ZigZagJoe/Acorn-A3010-Overclock-Board/Acorn Vent switch clip.stl

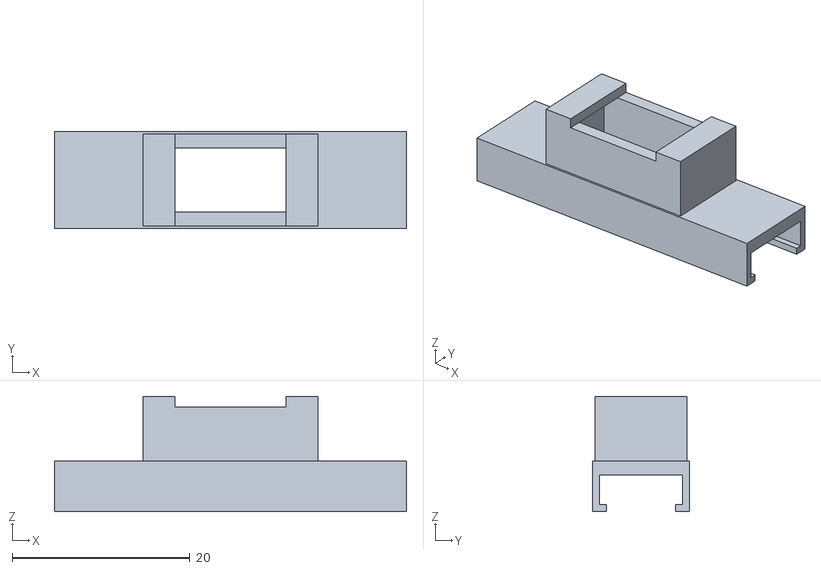
[picture p1: CAD file, 2026-11-02]
Acorn Vent switch clip.stl
39.6 x 10.9 x 13.0
