ZigZagJoe/Acorn-A3010-Overclock-Board/A3010 OC.kicad_pcb

## KiCad design A3010 OC.kicad_pcb (2026-11-02)

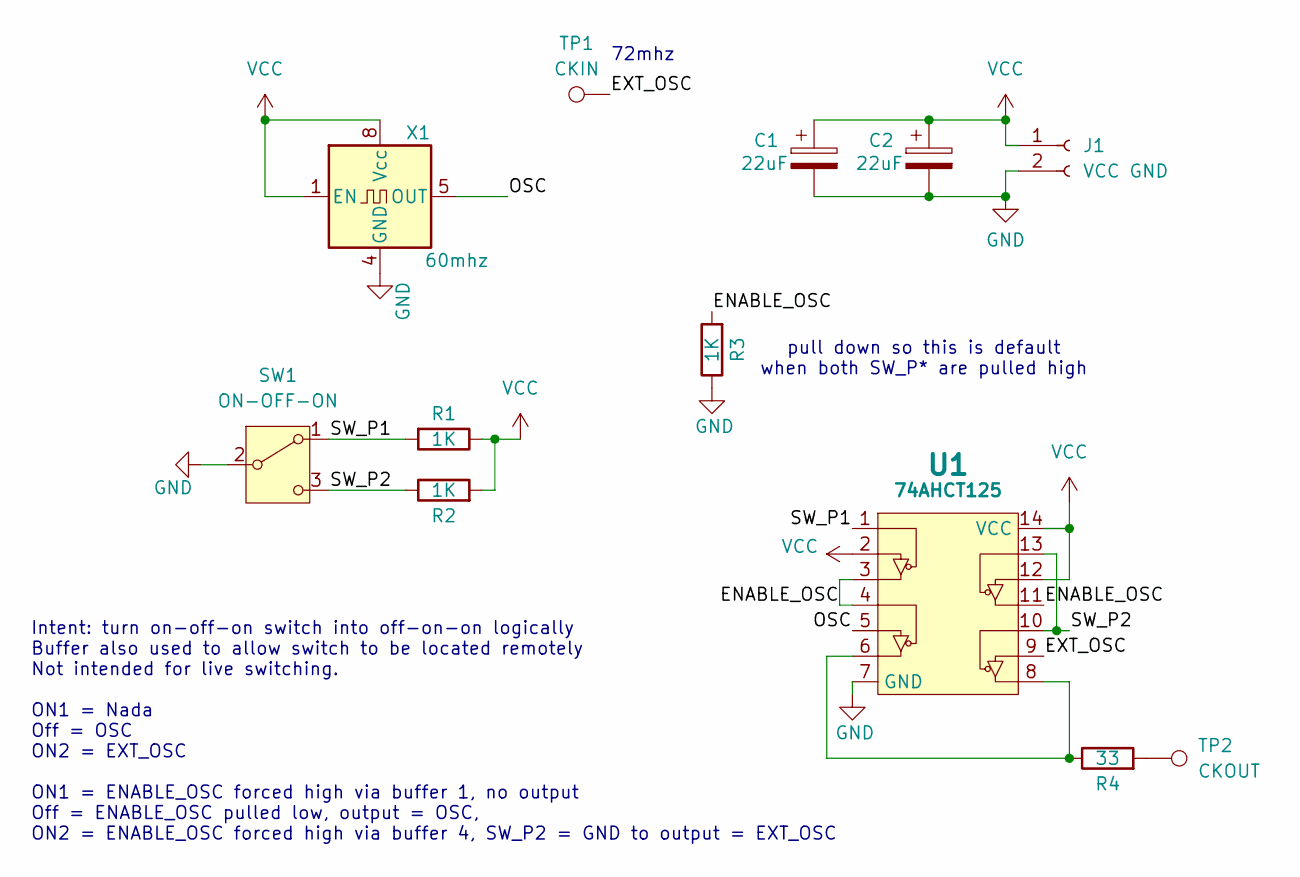
[picture p2: schematic A3010 OC.kicad_sch]

Parts:
C1, C2: 22uF; C_0805_2012Metric_Pad1.18x1.45mm_HandSolder; PartNumber CL21A226MAQNNNE; LCSC C45783
J1: VCC GND; PinHeader_1x02_P2.54mm_Vertical
R1, R2, R3: 1K; R_0805_2012Metric_HandSolder_XL; LCSC C23140
R4: 33; R_0805_2012Metric_HandSolder_XL; LCSC C23140
SW1: ON-OFF-ON; PinSocket_1x03_P2.54mm_Vertical
TP1: CKIN; TestPoint_THTPad_D2.0mm_Drill1.0mm
TP2: CKOUT; TestPoint_THTPad_D2.0mm_Drill1.0mm
U1: 74AHCT125; SOIC-14_3.9x8.7mm_P1.27mm_HandSolder; MOUSERPN SN74AHCT125DR
X1: 60mhz; Oscillator_DIP-8_DIP-14; LCSC n/a

Connections:
/ENABLE_OSC: R3.2, U1.3, U1.4, U1.11
/EXT_OSC: TP1.1, U1.9
/OSC: U1.5, X1.5 (OUT)
/SW_P1: R1.2, SW1.1 (A), U1.1
/SW_P2: R2.1, SW1.3 (C), U1.10, U1.13
GND: C1.2, C2.2, J1.2, R3.1, SW1.2 (B), U1.7 (GND), X1.4 (GND)
unnamed: R4.1, U1.6, U1.8
unnamed: R4.2, TP2.1
VCC: C1.1, C2.1, J1.1, R1.1, R2.2, U1.2, U1.12, U1.14 (VCC), X1.1 (EN), X1.8 (Vcc)

Notes on the sheet:
72mhz
Intent: turn on-off-on switch into off-on-on logically Buffer also used to allow switch to be located remotely Not intended for live switching. ON1 = Nada Off = OSC ON2 = EXT_OSC ON1 = ENABLE_OSC forced high via buffer 1, no output Off = ENABLE_OSC pulled low, output = OSC, ON2 = ENABLE_OSC forced 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
pull down so this is default when both SW_P* are pulled high

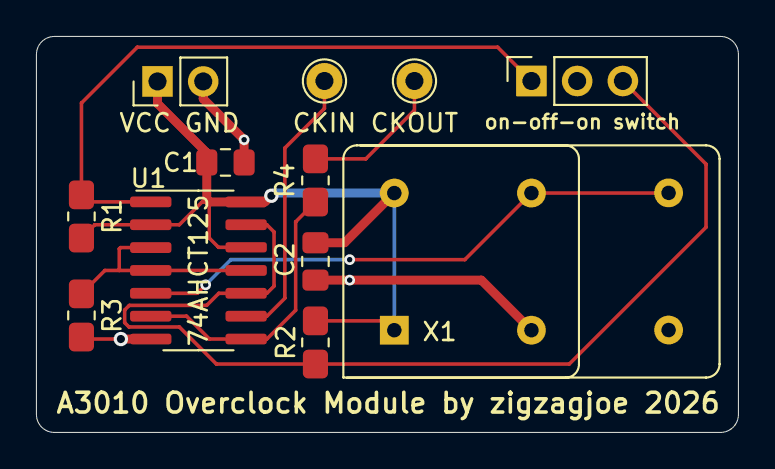
[picture p3: board A3010 OC.kicad_pcb from above]

Board: 2 copper layers, 39.0 x 22.0 mm, 12 parts (0 on the bottom side), 9 nets.
